crnjan/pabx/(commit log)

2021-08-30 fixed flow
2021-09-01 Added kicad files
    [pabx.kicad_pcb, pabx.sch]
2021-09-01 Added circuit
2021-09-02 MOS drivers are also powered through relay.
    [pabx.sch]
